cosmonaut/nixieclk/eagle/nixieclk.sch

## EAGLE design eagle/nixieclk.sch (2013-03-22)

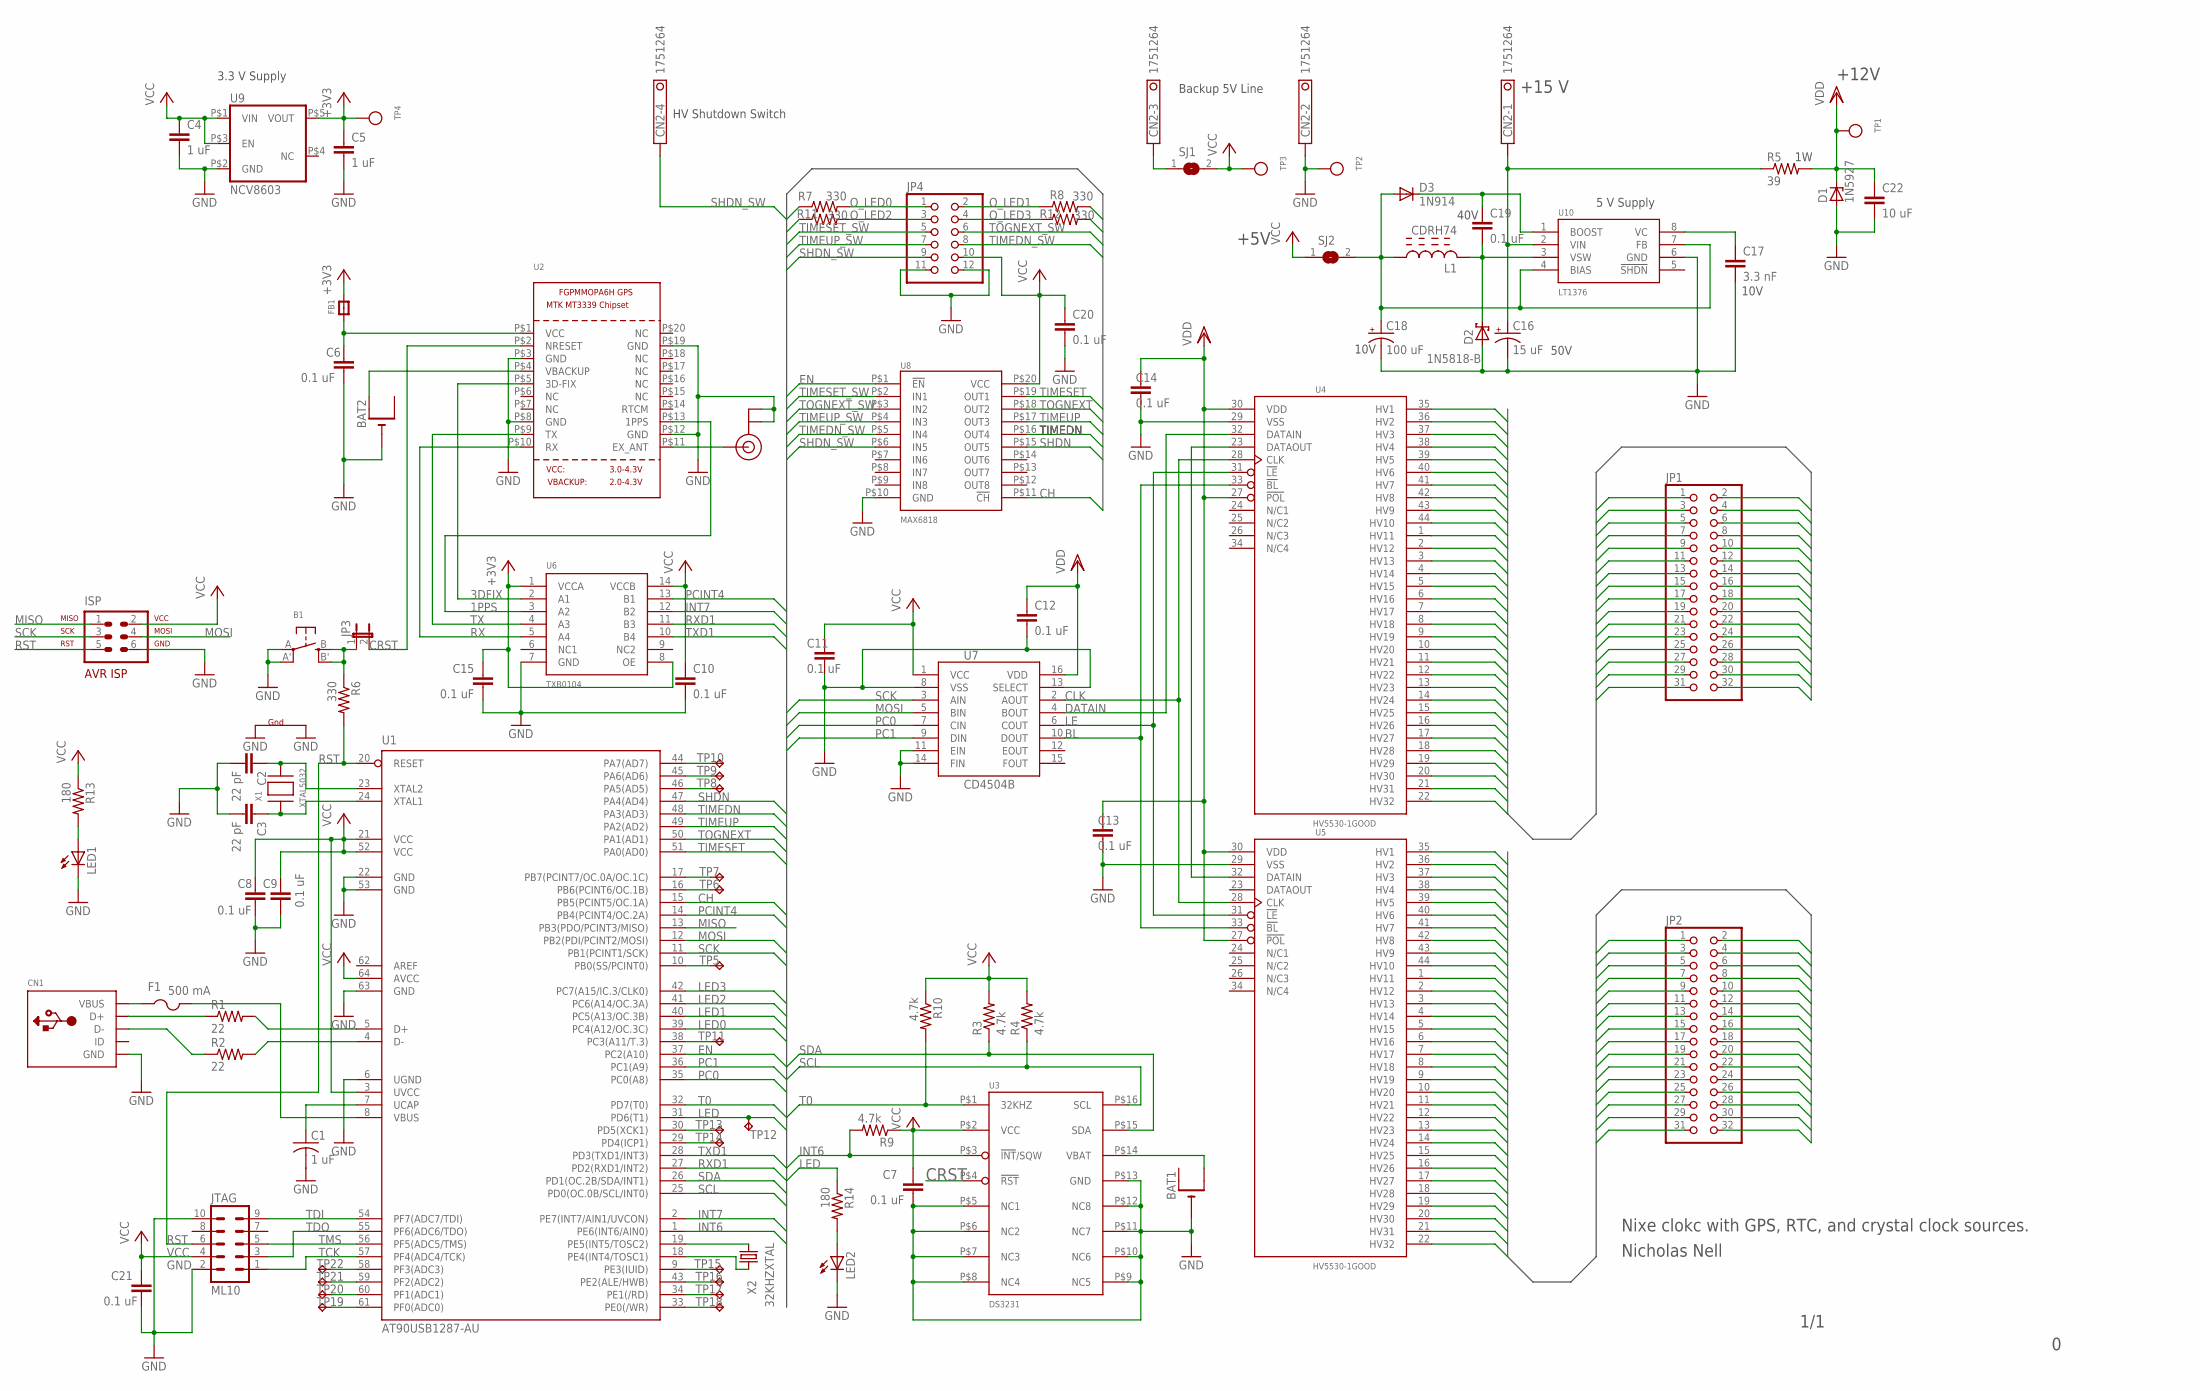
[picture p1: schematic nixieclk.sch]

Parts:
ANT: U.FL
B1: SWITCH_TACT_SMT; EVQ-Q2
BAT1, BAT2: CR1220SMT; CR1220-SMD
C1, C4, C5: 1 uF; C0805
C2, C3: 22 pF; C0805
C6, C7, C8, C9, C10, C11, C12, C13, C14, C15, C20, C21: 0.1 uF; C0805
C16: 15 uF; SMC_E
C17: 3.3 nF; C0805
C18: 100 uF; SMC_D
C19: 0.1 uF; C1812
C22: 10 uF; C0805
CN1: USBMINIB; USB-MINIB
CN2: 1751264
D1: 1N5927; DO41Z10
D2: 1N5818-B; DO41-7.6
D3: 1N914; DO35-7
F1: 500 mA; R1206
FB1: FERRITE_0805; _0805
ISP: AVR-ISP-6VERT; AVR-ISP-6
JP1, JP2: PINHD-2X16; 2X16
JP3: JUMPER2
JP4: PINHD-2X6; 2X06
JTAG: ML10
L1: CDRH74
LED1, LED2: LEDCHIPLED_0805; CHIPLED_0805
R1, R2: 22; R0805
R3, R4, R9, R10: 4.7k; R0805
R5: 39; 0207/10
R6, R7, R8, R11, R12: 330; R0805
R13, R14: 180; R0805
SJ1, SJ2: SJ
TP1, TP2, TP3, TP4: TESTPOINT0.1"; 1X01_ROUND
TP5, TP6, TP7, TP8, TP9, TP10, TP11, TP12, TP13, TP14, TP15, TP16, TP17, TP18, TP19, TP20, TP21, TP22: TPTP08R; TP08R
U1: AT90USB1287-AU; TQFP64
U2: GPS_FGPMMOPA6H; FGPMMOPA6H
U3: DS3231
U4, U5: HV5530-1GOOD; HV5530-PQFP-44
U6: TXB0104; SOIC14
U7: CD4504B; SO-16
U8: MAX6818; SSOP20
U9: NCV8603; TSOP5
U10: LT1376; S8
X1: XTAL5032; SX5032
X2: 32KHZXTAL; FX135

Connections:
1PPS: U2.P$13 (1PPS), U6.3 (A2)
2HV1: JP2.1, U5.35 (HV1)
2HV2: JP2.2, U5.36 (HV2)
2HV3: JP2.3, U5.37 (HV3)
2HV4: JP2.4, U5.38 (HV4)
2HV5: JP2.5, U5.39 (HV5)
2HV6: JP2.6, U5.40 (HV6)
2HV7: JP2.7, U5.41 (HV7)
2HV8: JP2.8, U5.42 (HV8)
2HV9: JP2.9, U5.43 (HV9)
2HV10: JP2.10, U5.44 (HV10)
2HV11: JP2.11, U5.1 (HV11)
2HV12: JP2.12, U5.2 (HV12)
2HV13: JP2.13, U5.3 (HV13)
2HV14: JP2.14, U5.4 (HV14)
2HV15: JP2.15, U5.5 (HV15)
2HV16: JP2.16, U5.6 (HV16)
2HV17: JP2.17, U5.7 (HV17)
2HV18: JP2.18, U5.8 (HV18)
2HV19: JP2.19, U5.9 (HV19)
2HV20: JP2.20, U5.10 (HV20)
2HV21: JP2.21, U5.11 (HV21)
2HV22: JP2.22, U5.12 (HV22)
2HV23: JP2.23, U5.13 (HV23)
2HV24: JP2.24, U5.14 (HV24)
2HV25: JP2.25, U5.15 (HV25)
2HV26: JP2.26, U5.16 (HV26)
2HV27: JP2.27, U5.17 (HV27)
2HV28: JP2.28, U5.18 (HV28)
2HV29: JP2.29, U5.19 (HV29)
2HV30: JP2.30, U5.20 (HV30)
2HV31: JP2.31, U5.21 (HV31)
2HV32: JP2.32, U5.22 (HV32)
3DFIX: U2.P$5 (3D-FIX), U6.2 (A1)
+3V3: C5.1, C15.1, FB1.2, TP4.1, U6.1 (VCCA), U6.8 (OE), U9.P$5 (VOUT)
BL: U4.33 (!BL), U5.33 (!BL), U7.10 (DOUT)
BOOST: C19.1, D3.P$1 (C), U10.1 (BOOST)
CH: U1.15 (PB5(PCINT5/OC.1A)), U8.P$11 (!CH)
CLK: U4.28 (CLK), U5.28 (CLK), U7.2 (AOUT)
CRST: JP3.2, U2.P$2 (NRESET), U3.P$4 (!RST)
DATAIN: U4.32 (DATAIN), U7.4 (BOUT)
EN: U1.37 (PC2(A10)), U8.P$1 (!EN)
GND: ANT.1 (GND), ANT.2 (GND), B1.A, B1.A' (P1), BAT1.-, BAT2.-, C1.2, C2.2, C3.2, C4.2, C5.2, C6.2, C7.2, C8.2, C9.2, C10.2, C11.2, C12.2, C13.2, C14.2, C15.2, C16.-, C17.2, C18.-, C20.2, C21.2, C22.2, CN1.GND, CN2.2, D1.A, D2.A, ISP.6, JP4.11, JP4.12, JTAG.2, JTAG.10, LED1.C, LED2.C, TP2.1, U1.6 (UGND), U1.22 (GND), U1.53 (GND), U1.63 (GND), U2.P$3 (GND), U2.P$8 (GND), U2.P$12 (GND), U2.P$19 (GND), U3.P$5 (NC1), U3.P$6 (NC2), U3.P$7 (NC3), U3.P$8 (NC4), U3.P$9 (NC5), U3.P$10 (NC6), U3.P$11 (NC7), U3.P$12 (NC8), U3.P$13 (GND), U4.29 (VSS), U5.29 (VSS), U6.7 (GND), U7.8 (VSS), U7.11 (EIN), U7.13 (SELECT), U7.14 (FIN), U8.P$10 (GND), U9.P$2 (GND), U10.6 (GND), X1.P$2 (G1), X1.P$4 (G2)
HV1: JP1.1, U4.35 (HV1)
HV2: JP1.2, U4.36 (HV2)
HV3: JP1.3, U4.37 (HV3)
HV4: JP1.4, U4.38 (HV4)
HV5: JP1.5, U4.39 (HV5)
HV6: JP1.6, U4.40 (HV6)
HV7: JP1.7, U4.41 (HV7)
HV8: JP1.8, U4.42 (HV8)
HV9: JP1.9, U4.43 (HV9)
HV10: JP1.10, U4.44 (HV10)
HV11: JP1.11, U4.1 (HV11)
HV12: JP1.12, U4.2 (HV12)
HV13: JP1.13, U4.3 (HV13)
HV14: JP1.14, U4.4 (HV14)
HV15: JP1.15, U4.5 (HV15)
HV16: JP1.16, U4.6 (HV16)
HV17: JP1.17, U4.7 (HV17)
HV18: JP1.18, U4.8 (HV18)
HV19: JP1.19, U4.9 (HV19)
HV20: JP1.20, U4.10 (HV20)
HV21: JP1.21, U4.11 (HV21)
HV22: JP1.22, U4.12 (HV22)
HV23: JP1.23, U4.13 (HV23)
HV24: JP1.24, U4.14 (HV24)
HV25: JP1.25, U4.15 (HV25)
HV26: JP1.26, U4.16 (HV26)
HV27: JP1.27, U4.17 (HV27)
HV28: JP1.28, U4.18 (HV28)
HV29: JP1.29, U4.19 (HV29)
HV30: JP1.30, U4.20 (HV30)
HV31: JP1.31, U4.21 (HV31)
HV32: JP1.32, U4.22 (HV32)
INT6: R9.2, U1.1 (PE6(INT6/AIN0)), U3.P$3 (!INT!/SQW)
INT7: U1.2 (PE7(INT7/AIN1/UVCON)), U6.12 (B2)
LE: U4.31 (!LE), U5.31 (!LE), U7.6 (COUT)
LED: R14.1, TP12.TP, U1.31 (PD6(T1))
LED0: R7.1, U1.39 (PC4(A12/OC.3C))
LED1: R8.2, U1.40 (PC5(A13/OC.3B))
LED2: R11.1, U1.41 (PC6(A14/OC.3A))
LED3: R12.2, U1.42 (PC7(A15/IC.3/CLK0))
MISO: ISP.1, U1.13 (PB3(PDO/PCINT3/MISO))
MOSI: ISP.4, U1.12 (PB2(PDI/PCINT2/MOSI)), U7.5 (BIN)
unnamed: R1.2, U1.5 (D+)
unnamed: R2.2, U1.4 (D-)
unnamed: CN1.D+, R1.1
unnamed: CN1.D-, R2.1
unnamed: F1.2, U1.8 (VBUS)
unnamed: C16.+, CN2.1, R5.1, U10.2 (VIN)
unnamed: U4.23 (DATAOUT), U5.32 (DATAIN)
unnamed: B1.B (S), B1.B' (S1), JP3.1, R6.1
unnamed: ANT.3 (SIGNAL), U2.P$11 (EX_ANT)
unnamed: BAT1.+$2 (+1), U3.P$14 (VBAT)
unnamed: BAT2.+$1 (+), U2.P$4 (VBACKUP)
unnamed: C1.1, U1.7 (UCAP)
unnamed: C6.1, FB1.1, U2.P$1 (VCC)
unnamed: C2.1, U1.23 (XTAL2), X1.P$3 (X2)
unnamed: TP5.TP, U1.10 (PB0(SS/PCINT0))
unnamed: TP6.TP, U1.16 (PB6(PCINT6/OC.1B))
unnamed: TP7.TP, U1.17 (PB7(PCINT7/OC.0A/OC.1C))
unnamed: C3.1, U1.24 (XTAL1), X1.P$1 (X1)
unnamed: C19.2, D2.C, L1.P$2 (2), U10.3 (VSW)
unnamed: C17.1, U10.8 (VC)
unnamed: TP8.TP, U1.46 (PA5(AD5))
unnamed: TP9.TP, U1.45 (PA6(AD6))
unnamed: TP10.TP, U1.44 (PA7(AD7))
unnamed: U1.18 (PE4(INT4/TOSC1)), X2.P$1 (1)
unnamed: U1.19 (PE5(INT5/TOSC2)), X2.P$2 (2)
unnamed: TP11.TP, U1.38 (PC3(A11/T.3))
unnamed: C18.+, D3.P$2 (A), L1.P$1 (1), SJ2.2, U10.4 (BIAS), U10.7 (FB)
unnamed: TP13.TP, U1.30 (PD5(XCK1))
unnamed: TP14.TP, U1.29 (PD4(ICP1))
unnamed: TP15.TP, U1.9 (PE3(IUID))
unnamed: TP16.TP, U1.43 (PE2(ALE/HWB))
unnamed: TP17.TP, U1.34 (PE1(/RD))
unnamed: TP18.TP, U1.33 (PE0(/WR))
unnamed: TP19.TP, U1.61 (PF0(ADC0))
unnamed: TP20.TP, U1.60 (PF1(ADC1))
unnamed: TP21.TP, U1.59 (PF2(ADC2))
unnamed: TP22.TP, U1.58 (PF3(ADC3))
unnamed: CN2.3, SJ1.1
unnamed: LED1.A, R13.2
unnamed: CN1.VBUS, F1.1
unnamed: LED2.A, R14.2
O_LED0: JP4.1, R7.2
O_LED1: JP4.2, R8.1
O_LED2: JP4.3, R11.2
O_LED3: JP4.4, R12.1
PC0: U1.35 (PC0(A8)), U7.7 (CIN)
PC1: U1.36 (PC1(A9)), U7.9 (DIN)
PCINT4: U1.14 (PB4(PCINT4/OC.2A)), U6.13 (B1)
RST: ISP.5, JTAG.6, R6.2, U1.20 (RESET)
RX: U2.P$10 (RX), U6.5 (A4)
RXD1: U1.27 (PD2(RXD1/INT2)), U6.11 (B3)
SCK: ISP.3, U1.11 (PB1(PCINT1/SCK)), U7.3 (AIN)
SCL: R4.1, U1.25 (PD0(OC.0B/SCL/INT0)), U3.P$16 (SCL)
SDA: R3.1, U1.26 (PD1(OC.2B/SDA/INT1)), U3.P$15 (SDA)
SHDN: U1.47 (PA4(AD4)), U8.P$15 (OUT5)
SHDN_SW: CN2.4, JP4.9, U8.P$6 (IN5)
T0: R10.2, U1.32 (PD7(T0)), U3.P$1 (32KHZ)
TCK: JTAG.1, U1.57 (PF4(ADC4/TCK))
TDI: JTAG.9, U1.54 (PF7(ADC7/TDI))
TDO: JTAG.3, U1.55 (PF6(ADC6/TDO))
TIMEDN: U1.48 (PA3(AD3)), U8.P$16 (OUT4)
TIMEDN_SW: JP4.8, U8.P$5 (IN4)
TIMESET: U1.51 (PA0(AD0)), U8.P$19 (OUT1)
TIMESET_SW: JP4.5, U8.P$2 (IN1)
TIMEUP: U1.49 (PA2(AD2)), U8.P$17 (OUT3)
TIMEUP_SW: JP4.7, U8.P$4 (IN3)
TMS: JTAG.5, U1.56 (PF5(ADC5/TMS))
TOGNEXT: U1.50 (PA1(AD1)), U8.P$18 (OUT2)
TOGNEXT_SW: JP4.6, U8.P$3 (IN2)
TX: U2.P$9 (TX), U6.4 (A3)
TXD1: U1.28 (PD3(TXD1/INT3)), U6.10 (B4)
VCC: C4.1, C7.1, C8.1, C9.1, C10.1, C11.1, C20.1, C21.1, ISP.2, JP4.10, JTAG.4, R3.2, R4.2, R9.1, R10.1, R13.1, SJ1.2, SJ2.1, TP3.1, U1.3 (UVCC), U1.21 (VCC), U1.52 (VCC), U1.64 (AVCC), U3.P$2 (VCC), U6.14 (VCCB), U7.1 (VCC), U8.P$20 (VCC), U9.P$1 (VIN), U9.P$3 (EN)
VDD: C12.1, C13.1, C14.1, C22.1, D1.C, R5.2, TP1.1, U4.27 (!POL), U4.30 (VDD), U5.27 (!POL), U5.30 (VDD), U7.16 (VDD)

Notes on the sheet:
+12V
+15 V
3.3 V Supply
40V
5 V Supply
HV Shutdown Switch
Backup 5V Line
50V
10V
1/1
+5V
Nixe clokc with GPS, RTC, and crystal clock sources.
Nicholas Nell
