cosmonaut/nixieclk/(commit log)

2013-03-22 Add version 1 of the pcb design and a readme
    [nixieclk.sch]
2013-05-11 Basic stripped down version that blinks status LED using DS3231 working
2013-05-12 Added simple uart and GPS echo
2013-05-28 GPS timesetting, status leds added
2013-06-08 Buffer indexing bug fix
    [ds3231.c]
2013-06-08 HV5530 support on SPI, nixie digit functions added
2013-06-15 Fix bug in nixie digit writing fuction
    [main.c]
2013-11-23 DST for now... real fix later
    [main.c]
2013-11-30 Add date/time display mode, remove usb connect/disconnect glitch
    [ds3231.c, ds3231.h, main.c, main.h]
2013-11-30 Minor fix for time display code
    [main.c]
